soggybag/Penfold-Fuzz-SMD/3dmodels/RV16AF-41.step

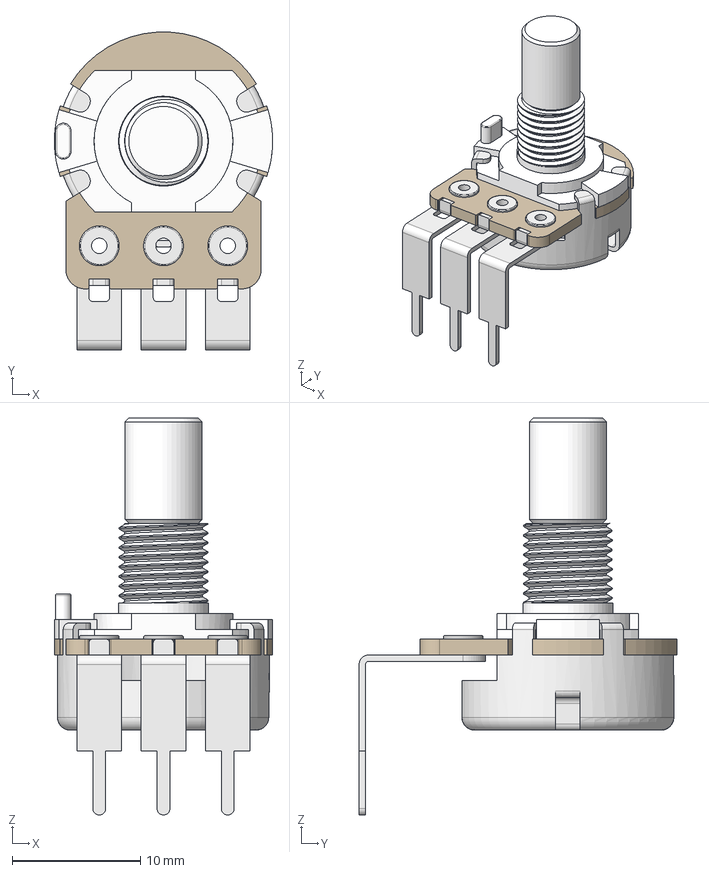
[picture p1: CAD file, 2026-10-07]
3dmodels/RV16AF-41.step
17.0 x 24.7 x 30.9 mm
