soggybag/Penfold-Fuzz-SMD/archive/v1.0/Penfold_Fuzz_board_back.pdf

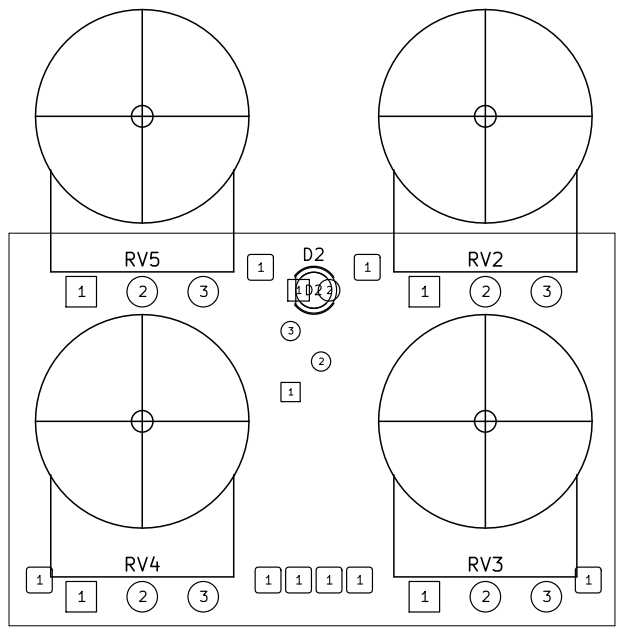
[picture p4: page 1]

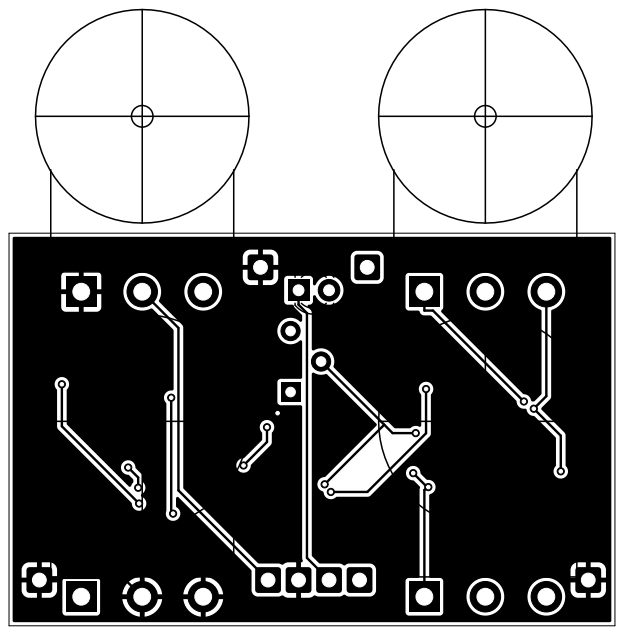
[picture p5: page 2]
