soggybag/Penfold-Fuzz-SMD/archive/v1.0/Penfold_Fuzz_board_front.pdf

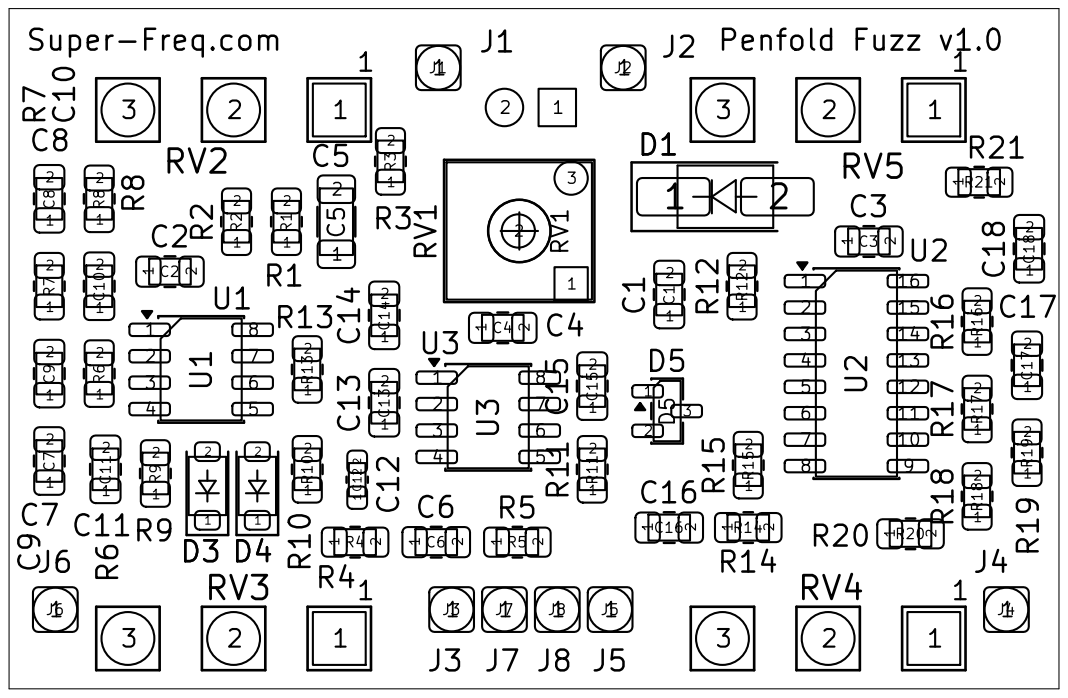
[picture p6: page 1]

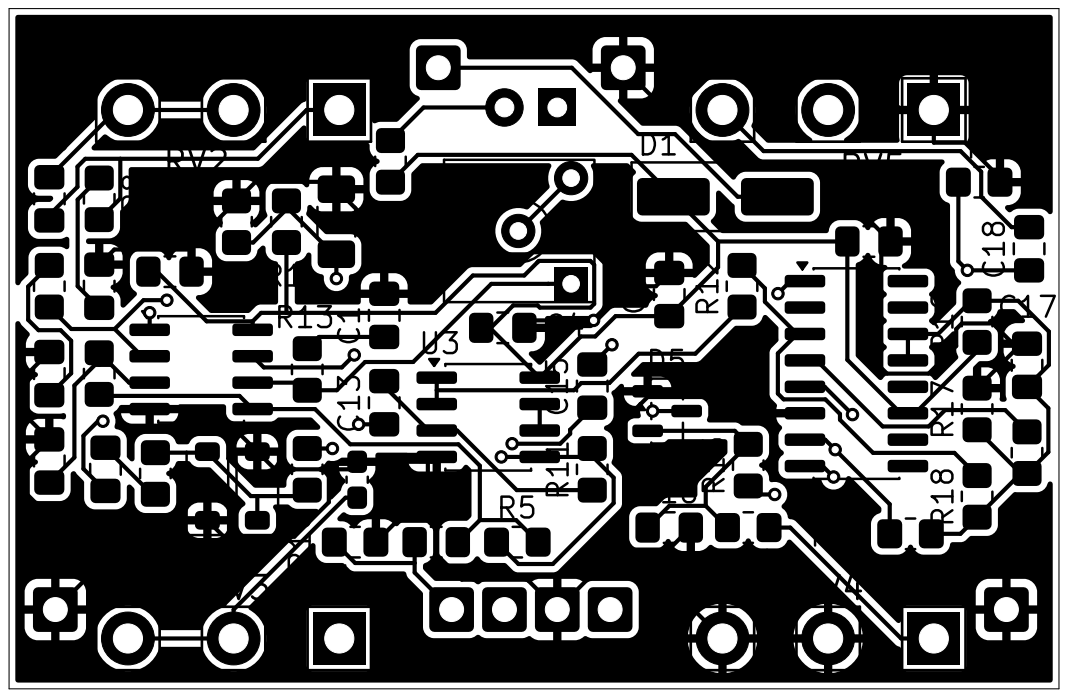
[picture p7: page 2]
