soggybag/Penfold-Fuzz-SMD/Penfold_Fuzz.kicad_pcb

## KiCad design Penfold_Fuzz.kicad_pcb (2026-10-07)

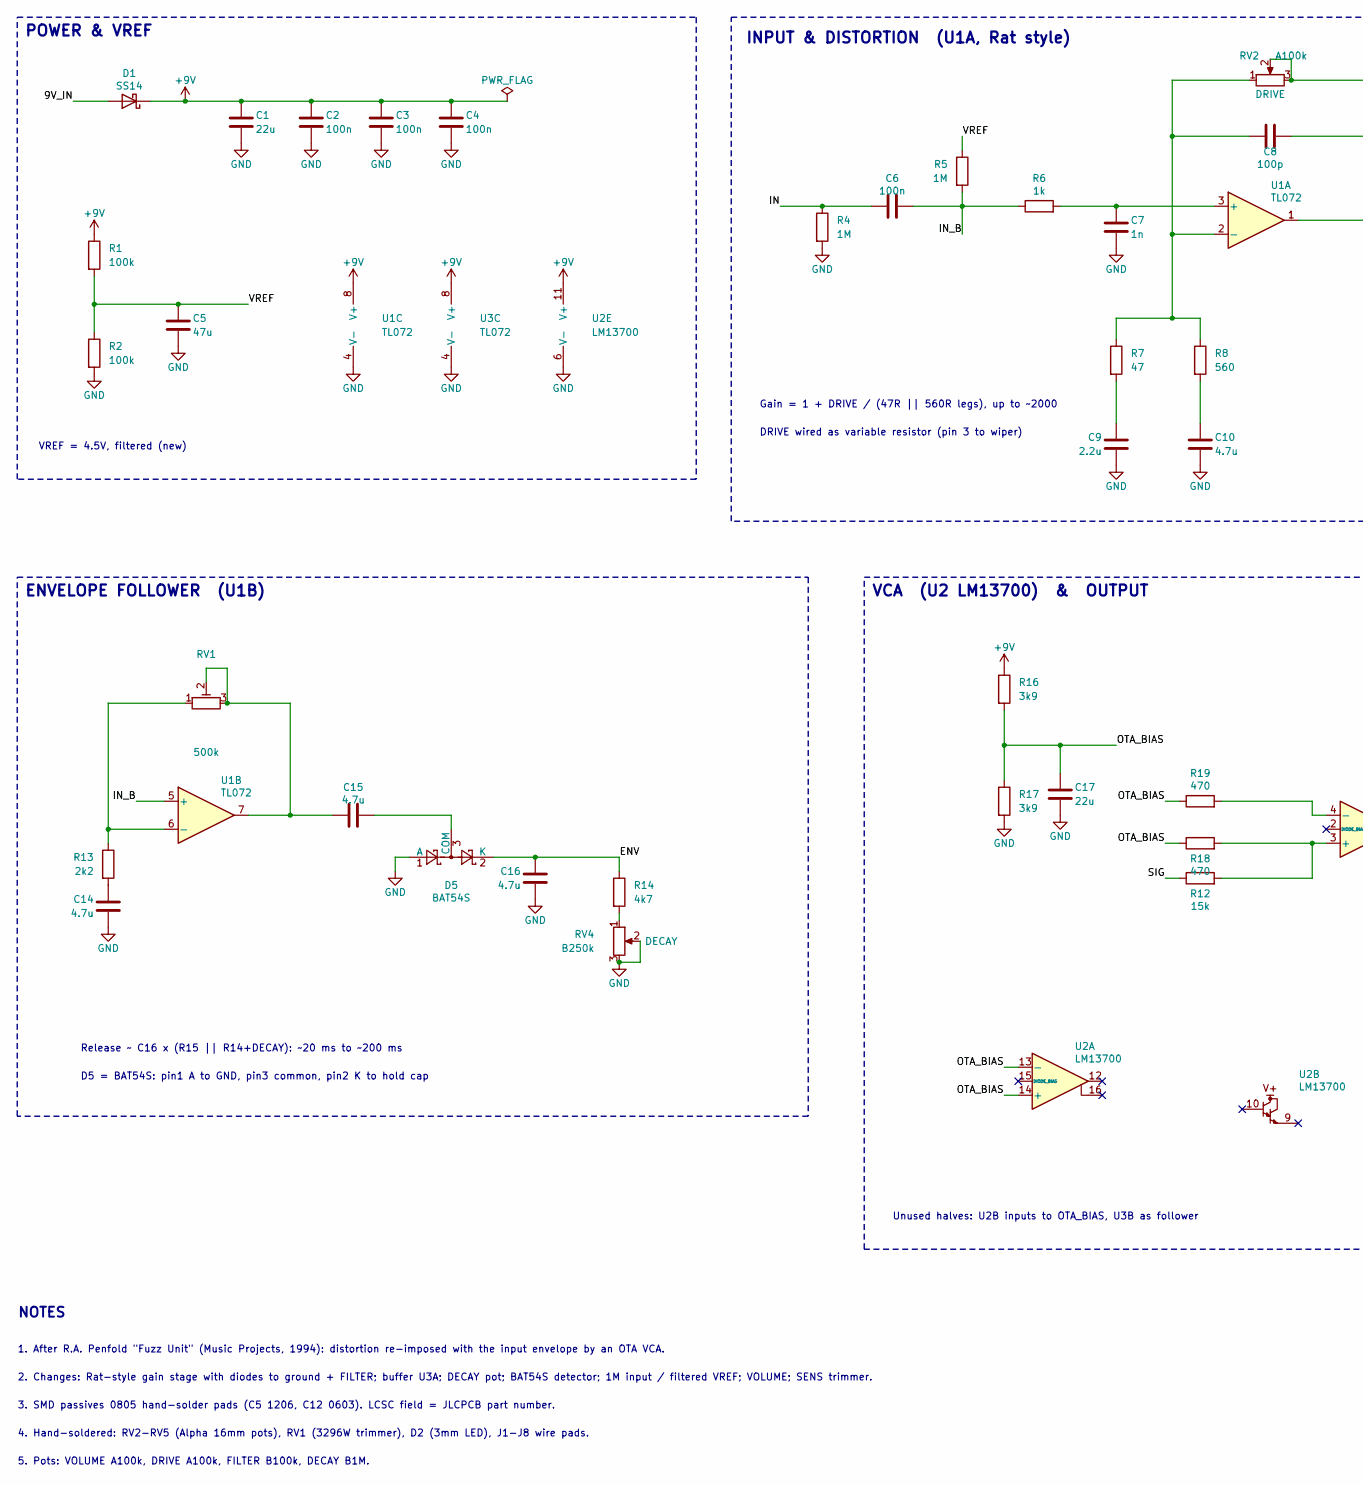
[picture p8: schematic Penfold_Fuzz.kicad_sch, Penfold Dynamic Fuzz - SMD, part in row 1, column 1]

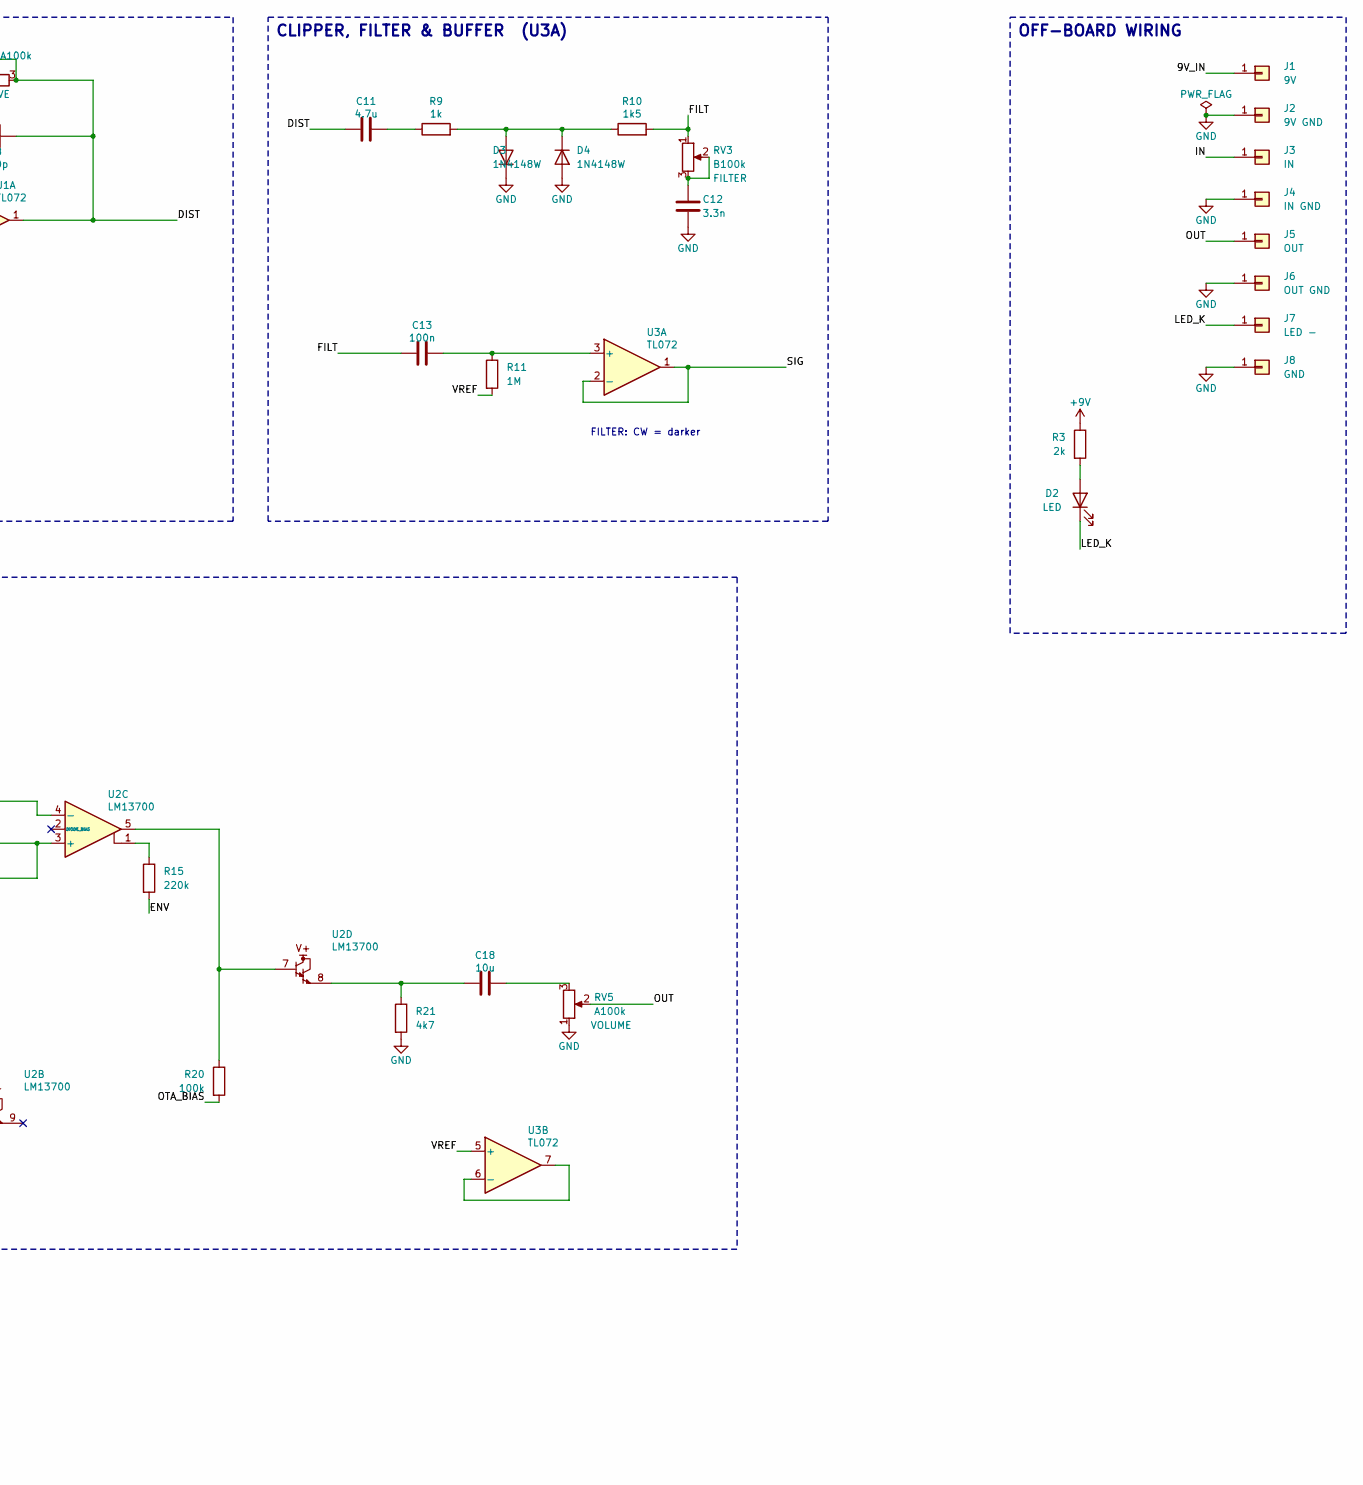
[picture p9: schematic Penfold_Fuzz.kicad_sch, Penfold Dynamic Fuzz - SMD, part in row 1, column 2]

Parts:
C1, C17: 22u; C_0805_2012Metric_Pad1.18x1.45mm_HandSolder; LCSC C45783
C2, C3, C4, C6, C13: 100n; C_0805_2012Metric_Pad1.18x1.45mm_HandSolder; LCSC C49678
C5: 47u; C_1206_3216Metric_Pad1.33x1.80mm_HandSolder; LCSC C96123
C7: 1n; C_0805_2012Metric_Pad1.18x1.45mm_HandSolder; LCSC C46653
C8: 100p; C_0805_2012Metric_Pad1.18x1.45mm_HandSolder; LCSC C1790
C9: 2.2u; C_0805_2012Metric_Pad1.18x1.45mm_HandSolder; LCSC C377773
C10, C11, C14, C15, C16: 4.7u; C_0805_2012Metric_Pad1.18x1.45mm_HandSolder; LCSC C1779
C12: 3.3n; C_0603_1608Metric_Pad1.08x0.95mm_HandSolder; LCSC C1613
C18: 10u; C_0805_2012Metric_Pad1.18x1.45mm_HandSolder; LCSC C15850
D1: SS14; D_SMA_Handsoldering; LCSC C2480
D2: LED; LED_D3.0mm
D3, D4: 1N4148W; D_SOD-123; LCSC C81598
D5: BAT54S; SOT-23; LCSC C19726
J1: 9V; SolderWire-0.5sqmm_1x01_D0.9mm_OD2.1mm
J2: 9V GND; SolderWire-0.5sqmm_1x01_D0.9mm_OD2.1mm
J3: IN; SolderWire-0.5sqmm_1x01_D0.9mm_OD2.1mm
J4: IN GND; SolderWire-0.5sqmm_1x01_D0.9mm_OD2.1mm
J5: OUT; SolderWire-0.5sqmm_1x01_D0.9mm_OD2.1mm
J6: OUT GND; SolderWire-0.5sqmm_1x01_D0.9mm_OD2.1mm
J7: LED -; SolderWire-0.5sqmm_1x01_D0.9mm_OD2.1mm
J8: GND; SolderWire-0.5sqmm_1x01_D0.9mm_OD2.1mm
R1, R2, R20: 100k; R_0805_2012Metric_Pad1.20x1.40mm_HandSolder; LCSC C149504
R3: 2k; R_0805_2012Metric_Pad1.20x1.40mm_HandSolder; LCSC C17604
R4, R5, R11: 1M; R_0805_2012Metric_Pad1.20x1.40mm_HandSolder; LCSC C17514
R6, R9: 1k; R_0805_2012Metric_Pad1.20x1.40mm_HandSolder; LCSC C17513
R7: 47; R_0805_2012Metric_Pad1.20x1.40mm_HandSolder; LCSC C17714
R8: 560; R_0805_2012Metric_Pad1.20x1.40mm_HandSolder; LCSC C28636
R10: 1k5; R_0805_2012Metric_Pad1.20x1.40mm_HandSolder; LCSC C4310
R12: 15k; R_0805_2012Metric_Pad1.20x1.40mm_HandSolder; LCSC C17475
R13: 2k2; R_0805_2012Metric_Pad1.20x1.40mm_HandSolder; LCSC C17520
R14, R21: 4k7; R_0805_2012Metric_Pad1.20x1.40mm_HandSolder; LCSC C17673
R15: 220k; R_0805_2012Metric_Pad1.20x1.40mm_HandSolder; LCSC C17556
R16, R17: 3k9; R_0805_2012Metric_Pad1.20x1.40mm_HandSolder; LCSC C17614
R18, R19: 470; R_0805_2012Metric_Pad1.20x1.40mm_HandSolder; LCSC C17710
RV1: 500k; Potentiometer_Bourns_3362P_Vertical
RV2, RV5: A100k; Potentiometer_Alpha_16mm_Vertical
RV3: B100k; Potentiometer_Alpha_16mm_Vertical
RV4: B250k; Potentiometer_Alpha_16mm_Vertical
U1, U3: TL072; SOIC-8_3.9x4.9mm_P1.27mm; LCSC C6961
U2: LM13700; SOIC-16_3.9x9.9mm_P1.27mm; LCSC C174050

Connections:
/9V_IN: D1.2 (A), J1.1
/DIST: C8.2, C11.1, RV2.2, RV2.3, U1.1
/ENV: C16.1, D5.2 (K), R14.1, R15.2
/FILT: C13.1, R10.2, RV3.1
/IN: C6.1, J3.1, R4.1
/IN_B: C6.2, R5.2, R6.1, U1.5 (+)
/LED_K: D2.1 (K), J7.1
/OTA_BIAS: C17.1, R16.2, R17.1, R18.1, R19.1, R20.2, U2.13 (-), U2.14 (+)
/OUT: J5.1, RV5.2
/SIG: R12.1, U3.1, U3.2 (-)
/VREF: C5.1, R1.2, R2.1, R5.1, R11.2, U3.5 (+)
unnamed: C9.1, R7.2
unnamed: C10.1, R8.2
unnamed: C11.2, R9.1
unnamed: C12.1, RV3.2, RV3.3
unnamed: C14.1, R13.2
unnamed: C15.1, RV1.2, RV1.3, U1.7
unnamed: C18.1, R21.1, U2.8
unnamed: C18.2, RV5.3
unnamed: D2.2 (A), R3.2
unnamed: D3.2 (A), D4.1 (K), R9.2, R10.1
unnamed: C15.2, D5.3 (COM)
unnamed: R14.2, RV4.1
unnamed: R15.1, U2.1
unnamed: R20.1, U2.5, U2.7
unnamed: C7.1, R6.2, U1.3 (+)
unnamed: C8.1, R7.1, R8.1, RV2.1, U1.2 (-)
unnamed: R13.1, RV1.1, U1.6 (-)
unnamed: R12.2, R18.2, U2.3 (+)
unnamed: R19.2, U2.4 (-)
unnamed: C13.2, R11.1, U3.3 (+)
unnamed: U3.6 (-), U3.7

Notes on the sheet:
ENVELOPE FOLLOWER (U1B)
OFF-BOARD WIRING
D5 = BAT54S: pin1 A to GND, pin3 common, pin2 K to hold cap
INPUT & DISTORTION (U1A, Rat style)
Unused halves: U2B inputs to OTA_BIAS, U3B as follower
VCA (U2 LM13700) & OUTPUT
Gain = 1 + DRIVE / (47R || 560R legs), up to ~2000
Release ~ C16 x (R15 || R14+DECAY): ~20 ms to ~200 ms
VREF = 4.5V, filtered (new)
CLIPPER, FILTER & BUFFER (U3A)
DRIVE wired as variable resistor (pin 3 to wiper)
1. After R.A. Penfold "Fuzz Unit" (Music Projects, 1994): distortion re-imposed with the input envelope by an OTA VCA.
2. Changes: Rat-style gain stage with diodes to ground + FILTER; buffer U3A; DECAY pot; BAT54S detector; 1M input / filtered VREF; VOLUME; SENS trimmer.
4. Hand-soldered: RV2-RV5 (Alpha 16mm pots), RV1 (3296W trimmer), D2 (3mm LED), J1-J8 wire pads.
NOTES
5. Pots: VOLUME A100k, DRIVE A100k, FILTER B100k, DECAY B1M.
POWER & VREF
3. SMD passives 0805 hand-solder pads (C5 1206, C12 0603). LCSC field = JLCPCB part number.
FILTER: CW = darker

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
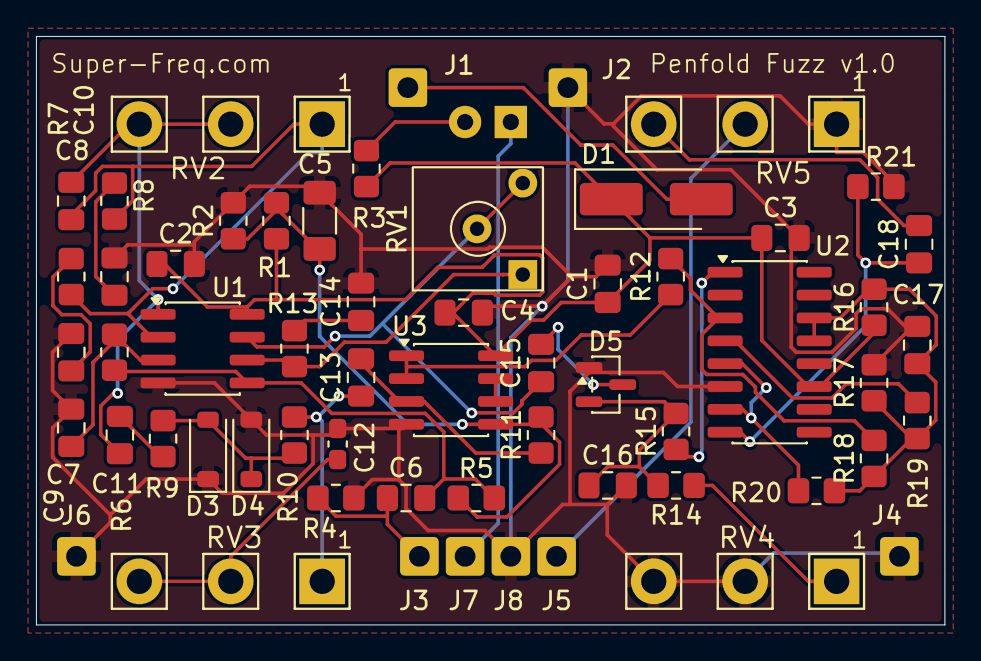
[picture p10: board Penfold_Fuzz.kicad_pcb from above]

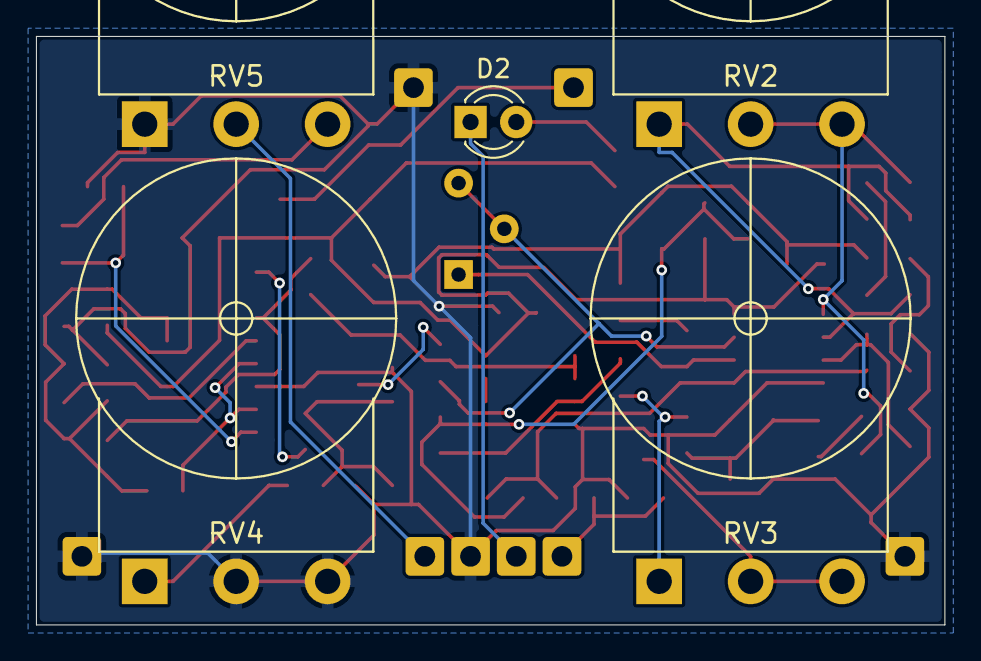
[picture p11: board Penfold_Fuzz.kicad_pcb from below]

Board: 2 copper layers, 50.5 x 32.7 mm, 61 parts (2 on the bottom side), 34 nets.

Other parts of the board:
ENC1: Hammond 1590B; Hammond_1590B
