soggybag/Penfold-Fuzz-SMD/(commit log)

2026-10-07 Penfold Fuzz SMD v1.0: Rat-style drive into an envelope-controlled LM13700 VCA, on the Ugly Face 1 board
    As ordered from JLCPCB (October 2026 batch).
    [1590B.stp, Penfold_Fuzz.kicad_pcb, Penfold_Fuzz.kicad_sch, RV16AF-41.step]
2026-10-07 Archive v1.0: schematic and board PDFs, renders, interactive BOM, parts list, docs and fab files
    [bom.csv, designators.csv, parts.csv, positions.csv]
2026-10-07 Roadmap: dynamic fuzz vs clean-up distortion, test Penfold first (envelope ripple, LED/LDR alternative)
2026-10-15 Penfold: test procedure with v1.0 results (FILTER wiring error, envelope findings), 1590B drill guide, transient-shaper roadmap
    [Penfold_1590B_drill.csv]
2026-10-18 Penfold: transient shaper sim (punch spike over sustain), air-wire punch test results, rough-attack suspects and tests, FILTER fix reminder
